Full-Blue-Racing/BSPD-27/BSPD-27_BOM.csv

Designators | Value | MPN | Distributor | Distributor code | Availability | Reference BOM (original) | Exact match? | Final confirm | Footprint | Footprint in KiCad lib? | Qty | Line price | Unit price
C1, C3, C6 | 100uF 25V | RVT1E101M0607 | LCSC | C72477 | In stock | 865080445010.0001 | No (equiv alu-elec) | Y | Capacitor_SMD:CP_Elec_6.3x7.7 | Yes | 3.0 | 0.1047 | 0.0349
C2, C4, C7, C8, C9, C10, C12, C14 | 0.1uF | CC0805KRX7R9BB104 | LCSC | C49678 | In stock | MT31B104K101CT | No (0805 X7R commercial) | Y | Capacitor_SMD:C_0805_2012Metric | Yes | 8.0 | 0.12000000000000001 | 0.015000000000000001
C5, C11, C13 | 10uF | CL21A106KAYNNNE | LCSC | C15850 | In stock | C1206C106J3RACAUTO | No (0805) | Y | Capacitor_SMD:C_0805_2012Metric | Yes | 3.0 | 0.23190000000000002 | 0.07730000000000001
COMP1, COMP2, COMP3 | MCP6547 (RRIO OD comp) | MCP6547T-E/MS | Farnell | 2851683.0 | In stock (65) | not in original BOM | n/a (AEC-Q100) | Y | Package_SO:MSOP-8_3x3mm_P0.65mm | Yes | 3.0 | 1.4100000000000001 | 0.47000000000000003
D1 | P6KE18A (18V TVS) | P6SMB18A | LCSC | C80394 | In stock (1,570) | P6KE18A | Yes - SMD sub for P6KE18A (uni-dir 600W) | OPEN | Diode_SMD:D_SMB | Yes | 1.0 | 0.152 | 0.152
D2 | 1N5822 (40V 3A) | 1N5822 | LCSC | C52023798 | In stock (44,570) | 1N5822 | Yes | Y | Diode_THT:D_DO-201AD_P12.70mm_Horizontal (verify pitch) | Yes | 1.0 | 0.059 | 0.059
D3, D4, D5, D6, D7, D8 | SMF5.0A | SZSMF5.0AT1G | LCSC | C5299833 | In stock (12,090) | SZSMF5.0AT1G | Yes (AEC-Q101) | Y | Diode_SMD:D_SOD-123F | Yes | 6.0 | 1.0176 | 0.1696
D9 | Green LED | KP-3216MGC | LCSC | C598294 | In stock (2,965) | AP3216MGC | Approx (LCSC rename of AP3216MGC) | Y | LED_SMD:LED_1206_3216Metric | Yes | 1.0 | 0.37300000000000005 | 0.37300000000000005
D10, D11 | Red LED | KP-3216SURC | LCSC | C598298 | In stock | 599-0P10-137F | No (Kingbright 1206; BOM Dialight n/a) | Y | LED_SMD:LED_1206_3216Metric | Yes | 2.0 | 0.060000000000000005 | 0.030000000000000002
F1 | PTC 1.1A | 1812L110/33GR | LCSC | C7542972 | In stock | not in original BOM | n/a | Y | Fuse:Fuse_1812_4532Metric | Yes | 1.0 | 0.0675 | 0.0675
FB1 | 1000ohm bead | CBW321609U102T | LCSC | C113327 | In stock | 782763102.0 | No (equiv 1206 1000ohm) | Y | Inductor_SMD:L_1206_3216Metric | Yes | 1.0 | 0.0412 | 0.0412
J1 | Connector 14-way | 776267-1 | Farnell | 2798126.0 | In stock (178) + your stock | 2301843-1 (D-sub 9) | N/a (AMPSEAL 14-way; your chosen replacement) | Y | TE AMPSEAL 776267 14-pos (get from UltraLibrarian/SnapEDA) | NO | 1.0 | 9.33 | 9.33
PS1 | DC-DC 5V 1A | R-78E5.0-1.0 | Farnell | 2760747.0 | In stock (6,255) | not in original BOM | n/a | Y | Converter_DCDC:Converter_DCDC_RECOM_R-78E-0.5_THT | Yes | 1.0 | 3.4200000000000004 | 3.4200000000000004
Q1, Q2, Q3, Q5 | N-MOSFET 30V | MMFTN3404A-AQ | Farnell | 4680838.0 | In stock (1,983) | MMFTN3402 | No (AEC-Q101 upgrade; BOM was non-AEC) | Y | Package_TO_SOT_SMD:SOT-23 | Yes | 4.0 | 1.62 | 0.405
Q4 | P-MOSFET 30V | MMFTP3401-AQ | Farnell | 4855254.0 | Lead time (order min 5) | MMFTP3401-AQ | Yes (AEC-Q101) | Y | Package_TO_SOT_SMD:SOT-23 | Yes | 1.0 | 0.3 | 0.3
R1, R6, R15, R20, R21 | 47k | 0805W8F4702T5E | LCSC | C17713 | In stock | CRGCQ1206J47K | No (0805 5% commercial) | Y | Resistor_SMD:R_0805_2012Metric | Yes | 5.0 | 0.011000000000000001 | 0.0022
R2, R3, R5, R7, R8, R10, R14, R18, R19 | 10k | 0805W8F1002T5E | LCSC | C17414 | In stock | CRCW120610K0JNEA | No (0805 5% commercial) | Y | Resistor_SMD:R_0805_2012Metric | Yes | 9.0 | 0.0148 | 0.0016
R4, R9, R11, R12, R13, R17, R25, R26 | 100k | ERA-8AEB104V | LCSC | C2073484 | In stock (5,615) | CRT1206-DY-1003ELF | No (0.1% AEC-Q200; BOM was 0.5%) | Y | Resistor_SMD:R_1206_3216Metric | Yes | 8.0 | 2.8544 | 0.3568
R16 | 1M | RT1206DRE071ML | LCSC | C872103 | In stock (1,540) | RT1206DRE071ML | Yes | Y | Resistor_SMD:R_1206_3216Metric | Yes | 1.0 | 0.0245 | 0.0245
R22, R23, R24 | 2.2k | ERA-8AEB222V | LCSC | C2075444 | In stock (3,180) | ERJ-P08D2201V | No (0.1% AEC-Q200; BOM was 0.5%) | Y | Resistor_SMD:R_1206_3216Metric | Yes | 3.0 | 0.43350000000000005 | 0.14450000000000002
RELAY1 | Relay SPDT 12V 15A | MCCMA51-S-DC12V-C | Farnell | 2008759.0 | In stock (4,809) | not in original BOM | n/a (automotive; 15A vs G5V-1 2A) | Y | TE CMA51 series (get from UltraLibrarian/SnapEDA) | NO | 1.0 | 2.15 | 2.15
VR1, VR2, VR3, VR4 | 100k trim (multiturn) | 3296W-1-104LF | LCSC | C48084 | In stock (13,933) | 3296W-1-104LF | Yes | Y | Potentiometer_THT:Potentiometer_Bourns_3296W_Vertical | Yes | 4.0 | 3.2648 | 0.8162
VR5, VR6 | 100k trim (SMD) | 3314G-1-104E | LCSC | C780219 | In stock (2,452) | 06TR4BA104DPR | No (CTS n/a on LCSC; Bourns 3314G SMD single-turn - same form/turns) | Y | Potentiometer_SMD:Potentiometer_Bourns_3314G_Vertical | Yes | 2.0 | 1.1342 | 0.5671
IC1 | Quad AND gate | SN74HC08QDRQ1 | LCSC | C2866596 | In stock (210) | MC74HC08ADR2G-Q | No (TI AEC-Q100 equiv; diff mfr) |  | Package_SO:SOIC-14_3.9x8.7mm_P1.27mm | Yes | 1.0 | 0.46220000000000006 | 0.46220000000000006
