Full-Blue-Racing/BSPD-27/production/BSPD27_bom.csv

Designator | Footprint | Quantity | Value | LCSC Part #
C1, C3, C6 | CP_Elec_6.3x7.7 | 3 | 100u 25V | C72477
C10, C12, C14, C15, C16, C2, C4, C7, C8, C9 | 0805 | 10 | 0.1u | C49678
C11, C13, C5 | 0805 | 3 | 10u | C15850
COMP1, COMP2, COMP3 | MSOP-8_3x3mm_P0.65mm | 3 | MCP6547-I_P | MCP6547T-E/MS
D1 | D_SMB | 1 | P6SMB18A | C80394
D10 | 1206 | 1 | Red | C598298
D11 | 1206 | 1 | PWR | C598298
D12 | D_DO-41_SOD81_P10.16mm_Horizontal | 1 | 1N5817 | C315569
D13 | 1206 | 1 | Thr_EN | C598298
D14 | 1206 | 1 | Thr_Plugged | C598294
D15 | 1206 | 1 | Brk_EN | C598298
D16 | 1206 | 1 | Brk_Plugged | C598294
D17 | 1206 | 1 | SEN_Implaus | C598298
D18 | 1206 | 1 | SEN_Unplugged | C598298
D19 | 1206 | 1 | R_on | C598298
D2 | D_DO-201AD_P12.70mm_Horizontal | 1 | 1N5822 | C52023798
D9 | 1206 | 1 | GRN | C598294
F1 | 1812 | 1 | 30R110 | C7542972
FB1 | 1206 | 1 | FerriteBead | C113327
IC1 | SOIC-14_3.9x8.7mm_P1.27mm | 1 | MC74HC08ADR2G-Q | C7578
J1 | TE_776267-1 | 1 | Conn_01x14
K1 | MCCMA51-S-DC12V-C | 1 | MCCMA51-S-DC12V-C
PS1 | Converter_DCDC_RECOM_R-78E-0.5_THT | 1 | R-78E5.0-1.0 | R-78E5.0-1.0
Q1, Q2, Q3, Q5 | SOT-23 | 4 | MMFTN3404A-AQ | MMFTN3404A-AQ
Q4 | SOT-23 | 1 | MMFTP3401-AQ | MMFTP3401-AQ
R1, R15, R20, R21, R7 | 0805 | 5 | 47k | C17713
R10, R22, R23, R24, R28, R29, R33, R34, R35, R4 | 1206 | 10 | 1k | C4410
R11, R12, R13, R17, R25, R27, R6 | 1206 | 7 | 100k | C2073484
R14, R18, R19, R2, R26, R3, R36, R37, R38, R5, R8, R9 | 0805 | 12 | 10k | C17414
R16 | 1206 | 1 | 1M | C872103
R30, R32 | 1206 | 2 | 5.1k | C2933721
R31 | 1206 | 1 | 91k | C2933797
TP1 | TestPoint_Loop_D2.54mm_Drill1.5mm_Beaded | 1 | BRK_IN
TP10 | TestPoint_Pad_D2.0mm | 1 | Thr_Thresh-
TP11 | TestPoint_Loop_D2.54mm_Drill1.5mm_Beaded | 1 | Brk_Thresh+
TP2 | TestPoint_Loop_D2.54mm_Drill1.5mm_Beaded | 1 | THR_IN
TP3 | TestPoint_Loop_D2.54mm_Drill1.5mm_Beaded | 1 | RC_T05
TP4 | TestPoint_Loop_D2.54mm_Drill1.5mm_Beaded | 1 | RC_T10
TP5 | TestPoint_Loop_D2.54mm_Drill1.5mm_Beaded | 1 | Thr_Thresh+
TP6 | TestPoint_Loop_D2.54mm_Drill1.5mm_Beaded | 1 | GND
TP7 | TestPoint_Pad_D2.0mm | 1 | Brk_Thresh-
TP8 | TestPoint_Loop_D2.54mm_Drill1.5mm_Beaded | 1 | +12V
TP9 | TestPoint_Pad_D2.0mm | 1 | R_on
U1 | SOIC-14_3.9x8.7mm_P1.27mm | 1 | 74HC00 | C10090
U3 | SOIC-16_3.9x9.9mm_P1.27mm | 1 | ULN2003A | C7512
U4 | SOIC-14_3.9x8.7mm_P1.27mm | 1 | LM2901 | C7932
U5 | SOIC-14_3.9x8.7mm_P1.27mm | 1 | 74HC02 | C350559
VR1 | Potentiometer_Bourns_3296W_Vertical | 1 | Brk_Thresh+ | C48084
VR2 | Potentiometer_Bourns_3296W_Vertical | 1 | Thr_Thresh+ | C48084
VR3, VR4 | Potentiometer_Bourns_3296W_Vertical | 2 | 3296W-1-xxxLF | C48084
VR5, VR6 | Potentiometer_Bourns_3314G_Vertical | 2 | 3314G | C780219
VR7 | Potentiometer_Bourns_3296W_Vertical | 1 | Brk_Thresh- | C48084
VR8 | Potentiometer_Bourns_3296W_Vertical | 1 | Thr_Thresh- | C48084
