Full-Blue-Racing/BSPD-27/production/BSPD27_bom_farnell.csv

Designator | Footprint | Quantity | Value | Farnell Part #
C1, C3, C6 | CP_Elec_6.3x7.7 | 3 | 100u 25V | 9265708
C10, C12, C14, C15, C16, C2, C4, C7, C8, C9 | 0805 | 10 | 0.1u | 2496944
C11, C13, C5 | 0805 | 3 | 10u | 2320833
COMP1, COMP2, COMP3 | MSOP-8_3x3mm_P0.65mm | 3 | MCP6547-I_P | 2851683
D1 | D_SMB | 1 | P6SMB18A | 1886331
D10 | 1206 | 1 | Red | 8530114
D11 | 1206 | 1 | PWR | 8530114
D12 | D_DO-41_SOD81_P10.16mm_Horizontal | 1 | 1N5817 | 9843787
D13 | 1206 | 1 | Thr_EN | 8530114
D14 | 1206 | 1 | Thr_Plugged | 2099244
D15 | 1206 | 1 | Brk_EN | 8530114
D16 | 1206 | 1 | Brk_Plugged | 2099244
D17 | 1206 | 1 | SEN_Implaus | 8530114
D18 | 1206 | 1 | SEN_Unplugged | 8530114
D19 | 1206 | 1 | R_on | 8530114
D2 | D_DO-201AD_P12.70mm_Horizontal | 1 | 1N5822 | 2322473
D9 | 1206 | 1 | GRN | 2099244
F1 | 1812 | 1 | 30R110 | 2383302
FB1 | 1206 | 1 | FerriteBead | 2292418
IC1 | SOIC-14_3.9x8.7mm_P1.27mm | 1 | MC74HC08ADR2G-Q | 1201314
K1 | MCCMA51-S-DC12V-C | 1 | MCCMA51-S-DC12V-C | 2008759
PS1 | Converter_DCDC_RECOM_R-78E-0.5_THT | 1 | R-78E5.0-1.0 | 2760747
Q1, Q2, Q3, Q5 | SOT-23 | 4 | MMFTN3404A-AQ | 4680838
Q4 | SOT-23 | 1 | MMFTP3401 | 4710426
R1, R15, R20, R21, R7 | 0805 | 5 | 47k | 2502732
R10, R22, R23, R24, R28, R29, R33, R34, R35, R4 | 1206 | 10 | 1k | 2447473
R11, R12, R13, R17, R25, R27, R6 | 1206 | 7 | 100k | 2447453
R14, R18, R19, R2, R26, R3, R36, R37, R38, R5, R8, R9 | 0805 | 12 | 10k | 2447553
R16 | 1206 | 1 | 1M | 2447478
R30, R32 | 1206 | 2 | 5.1k | 2695164
R31 | 1206 | 1 | 91k | 2074711
TP1, TP2, TP3, TP4, TP5, TP6, TP8, TP11 | TestPoint_Loop_D2.54mm_Drill1.5mm_Beaded | 8 | PCB Test Point (Vero 20-313141) | 2668702
U1 | SOIC-14_3.9x8.7mm_P1.27mm | 1 | 74HC00 | 1201310
U3 | SOIC-16_3.9x9.9mm_P1.27mm | 1 | ULN2003ADR | 3009692
U4 | SOIC-14_3.9x8.7mm_P1.27mm | 1 | LM2901DT | 2382614
U5 | SOIC-14_3.9x8.7mm_P1.27mm | 1 | 74HC02 | 1201312
VR1 | Potentiometer_Bourns_3296W_Vertical | 1 | Brk_Thresh+ | 9353186
VR2 | Potentiometer_Bourns_3296W_Vertical | 1 | Thr_Thresh+ | 9353186
VR3, VR4 | Potentiometer_Bourns_3296W_Vertical | 2 | 3296W-1-xxxLF | 9353186
VR5, VR6 | Potentiometer_Bourns_3314G_Vertical | 2 | 3314G | 1360937
VR7 | Potentiometer_Bourns_3296W_Vertical | 1 | Brk_Thresh- | 9353186
VR8 | Potentiometer_Bourns_3296W_Vertical | 1 | Thr_Thresh- | 9353186
