Full-Blue-Racing/BSPD-27/BSPD-E.pdf

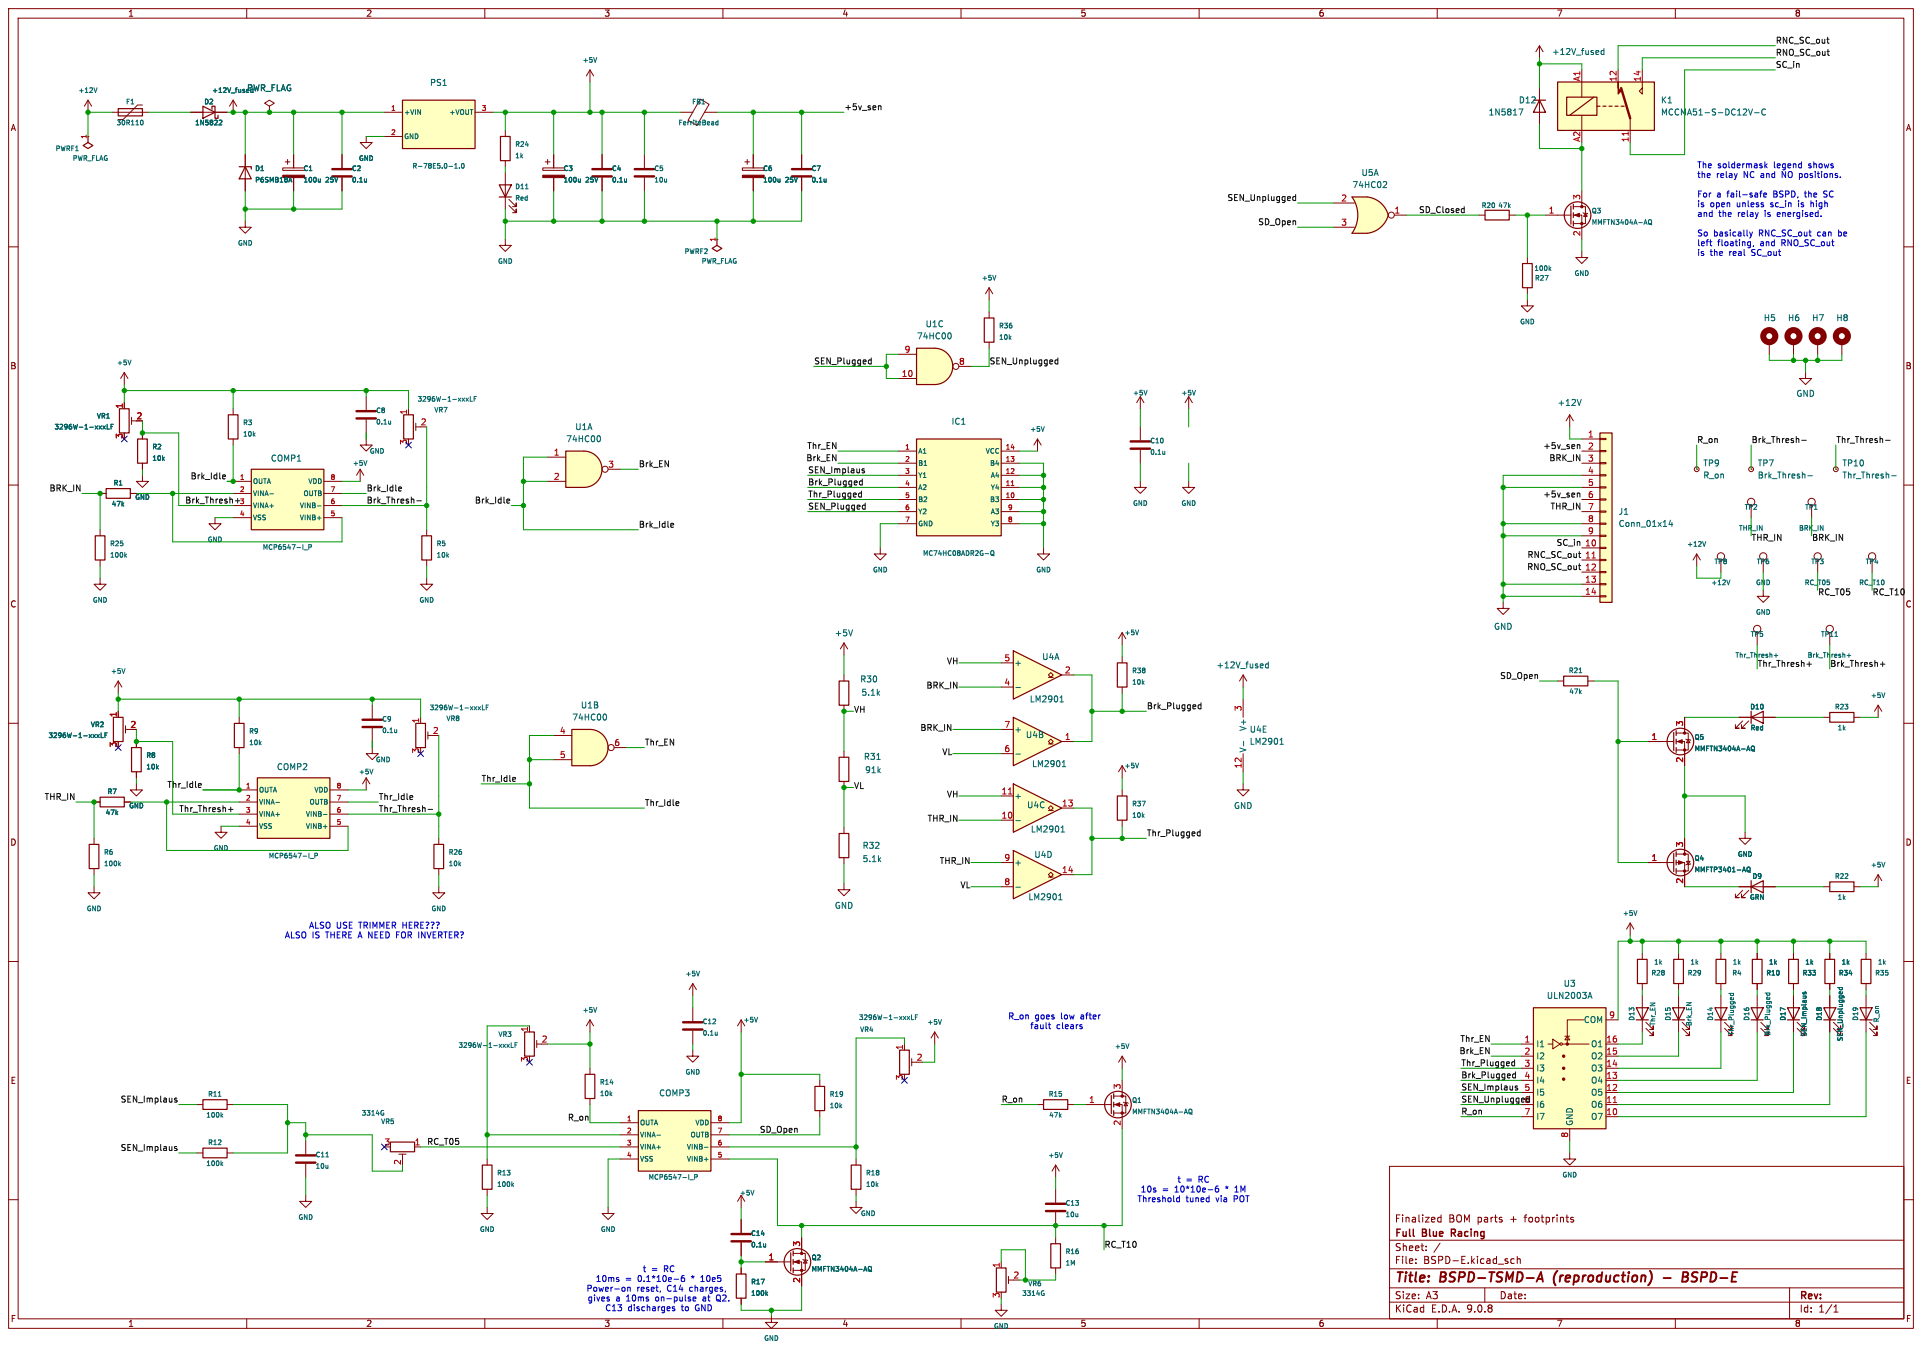
[picture p1: page 1]

is open unless sc_in is high

Threshold tuned via POT Q2 MMFTN3404A-AQ
