Full-Blue-Racing/BSPD-27/BSPD-27.kicad_pcb

## KiCad design BSPD-27.kicad_pcb (2026-10-11)

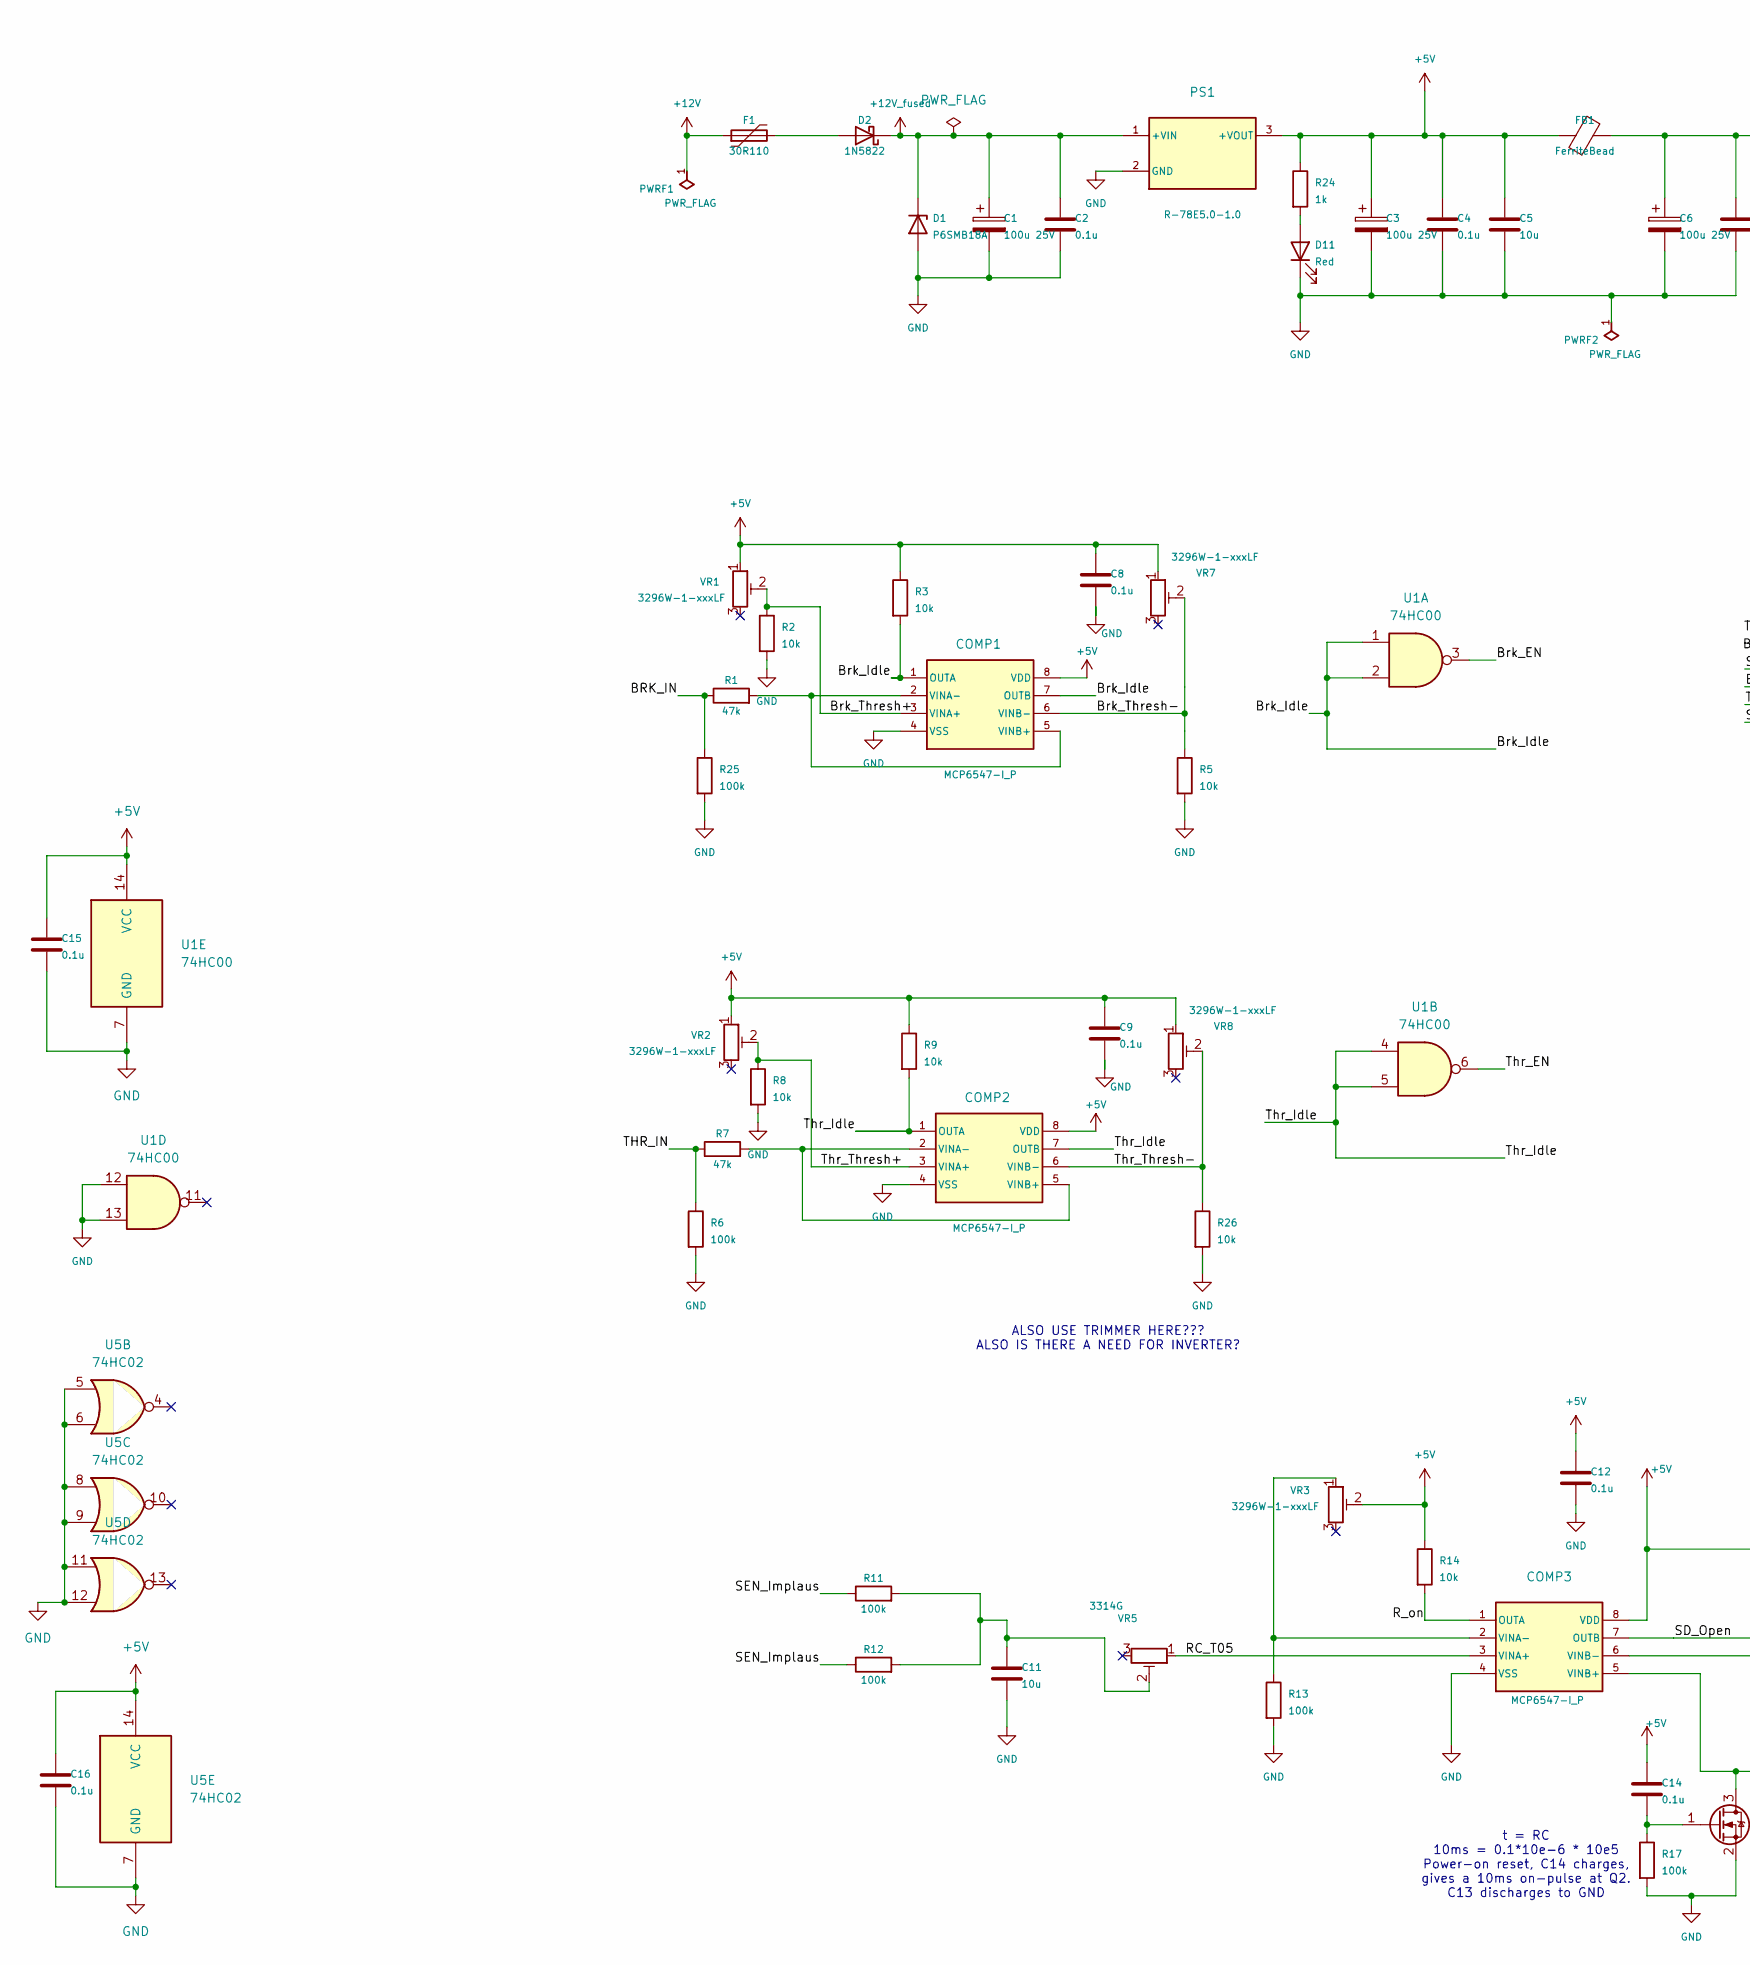
[picture p2: schematic BSPD-27.kicad_sch, BSPD-TSMD-A (reproduction) - BSPD-E, part in row 1, column 1]

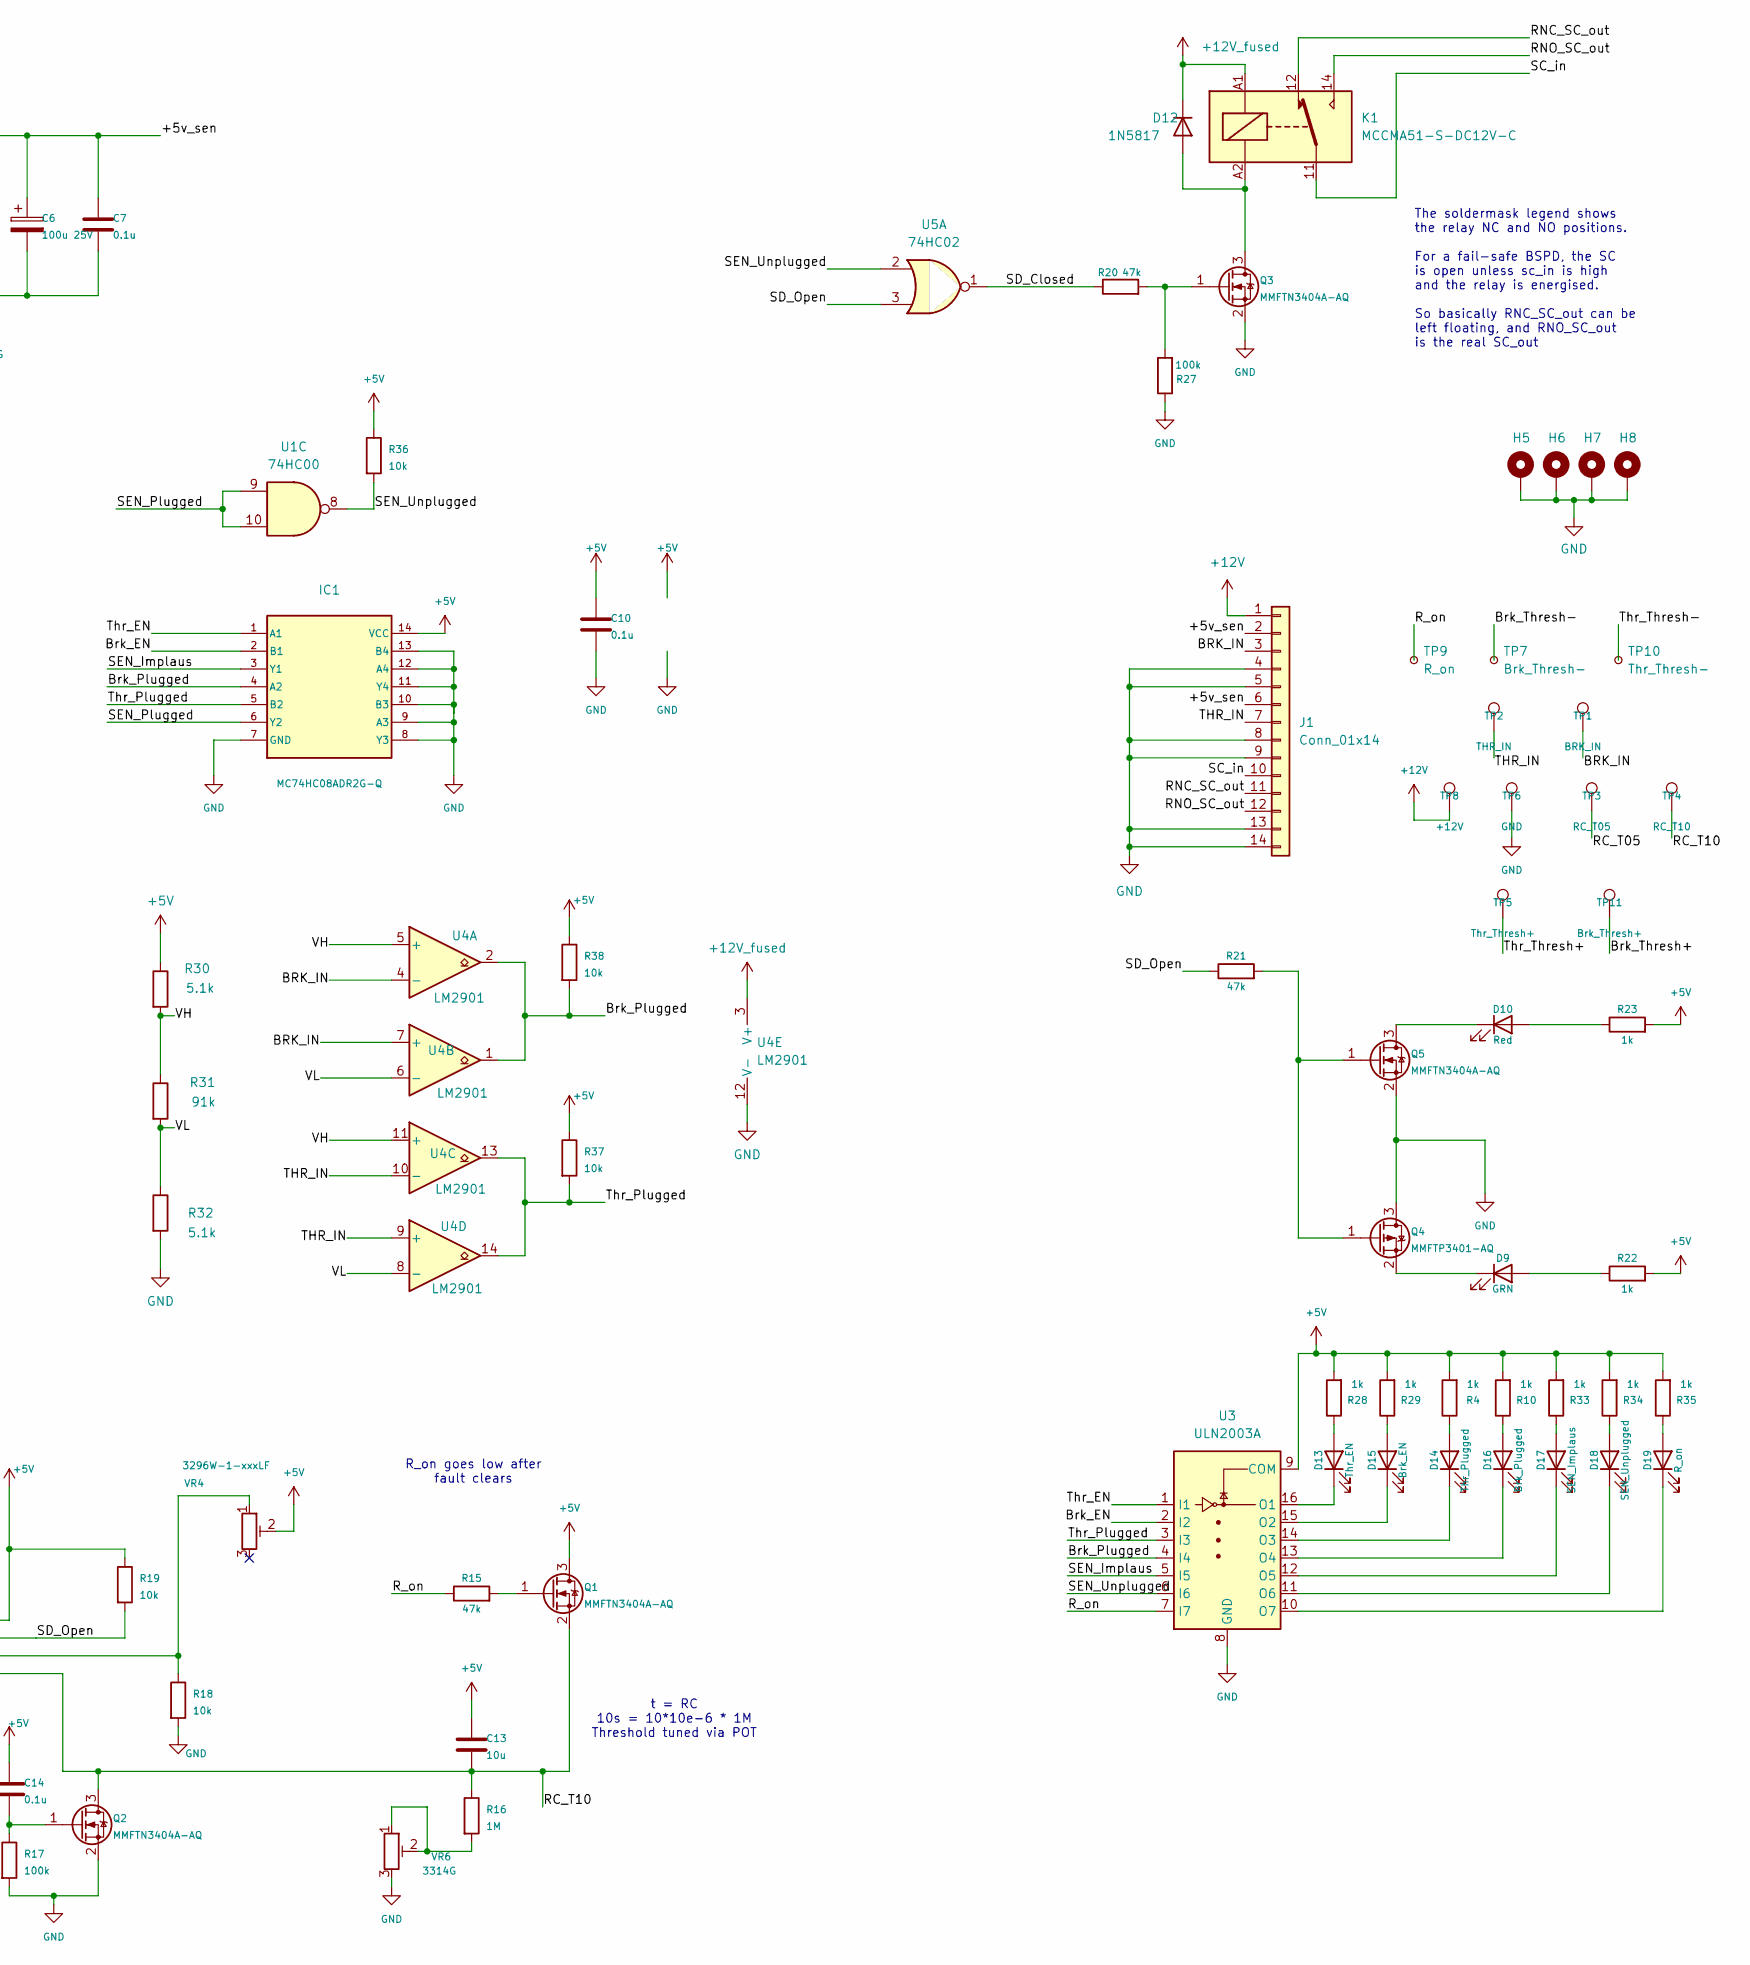
[picture p3: schematic BSPD-27.kicad_sch, BSPD-TSMD-A (reproduction) - BSPD-E, part in row 1, column 2]

Parts:
C1, C3, C6: 100u 25V; CP_Elec_6.3x7.7; MPN RVT1E101M0607; LCSC C72477
C2, C4, C7, C8, C9, C10, C12, C14, C15, C16: 0.1u; C_0805_2012Metric; MPN CC0805KRX7R9BB104; LCSC C49678
C5, C11, C13: 10u; C_0805_2012Metric; MPN CL21A106KAYNNNE; LCSC C15850
COMP1, COMP2, COMP3: MCP6547-I_P; MSOP-8_3x3mm_P0.65mm; MPN MCP6547T-E/MS; Farnell 2851683
D1: P6SMB18A; D_SMB; MPN P6SMB18A; LCSC C80394
D2: 1N5822; D_DO-201AD_P12.70mm_Horizontal; MPN 1N5822; LCSC C52023798
D9: GRN; LED_1206_3216Metric; MPN KP-3216MGC; LCSC C598294
D10, D11: Red; LED_1206_3216Metric; MPN KP-3216SURC; LCSC C598298
D12: 1N5817; D_DO-41_SOD81_P10.16mm_Horizontal; MPN 1N5817; LCSC C315569
D13: Thr_EN; LED_1206_3216Metric; MPN KP-3216SURC; LCSC C598298
D14: Thr_Plugged; LED_1206_3216Metric; MPN KP-3216MGC; LCSC C598294
D15: Brk_EN; LED_1206_3216Metric; MPN KP-3216SURC; LCSC C598298
D16: Brk_Plugged; LED_1206_3216Metric; MPN KP-3216MGC; LCSC C598294
D17: SEN_Implaus; LED_1206_3216Metric; MPN KP-3216SURC; LCSC C598298
D18: SEN_Unplugged; LED_1206_3216Metric; MPN KP-3216SURC; LCSC C598298
D19: R_on; LED_1206_3216Metric; MPN KP-3216SURC; LCSC C598298
F1: 30R110; Fuse_1812_4532Metric; MPN 1812L110/33GR; LCSC C7542972
FB1: FerriteBead; L_1206_3216Metric; MPN CBW321609U102T; LCSC C113327
H5, H6, H7, H8: MountingHole_Pad; MountingHole_3.2mm_M3_Pad_Via
IC1: MC74HC08ADR2G-Q; SOIC-14_3.9x8.7mm_P1.27mm; MPN MC74HC08ADR2G; LCSC C7578
J1: Conn_01x14; TE_776267-1
K1: MCCMA51-S-DC12V-C
PS1: R-78E5.0-1.0; Converter_DCDC_RECOM_R-78E-0.5_THT; MPN R-78E5.0-1.0; Farnell 2760747
PWRF1, PWRF2: PWR_FLAG
Q1, Q2, Q3, Q5: MMFTN3404A-AQ; SOT-23; MPN MMFTN3404A-AQ; Farnell 4680838
Q4: MMFTP3401-AQ; SOT-23; MPN MMFTP3401-AQ; Farnell 4855254
R1, R7, R15, R20, R21: 47k; R_0805_2012Metric; MPN 0805W8F4702T5E; LCSC C17713
R2, R3, R5, R8, R9, R14, R18, R19, R26, R36, R37, R38: 10k; R_0805_2012Metric; MPN 0805W8F1002T5E; LCSC C17414
R4, R10, R22, R23, R24, R28, R29, R33, R34, R35: 1k; R_1206_3216Metric; MPN 1206W4F1001T5E; LCSC C4410
R6, R11, R12, R13, R17, R25, R27: 100k; R_1206_3216Metric; MPN ERA-8AEB104V; LCSC C2073484
R16: 1M; R_1206_3216Metric; MPN RT1206DRE071ML; LCSC C872103
R30, R32: 5.1k; R_1206_3216Metric; MPN FRC1206F5101TS; LCSC C2933721
R31: 91k; R_1206_3216Metric; MPN FRC1206J913TS; LCSC C2933797
TP1: BRK_IN; TestPoint_Loop_D2.54mm_Drill1.5mm_Beaded
TP2: THR_IN; TestPoint_Loop_D2.54mm_Drill1.5mm_Beaded
TP3: RC_T05; TestPoint_Loop_D2.54mm_Drill1.5mm_Beaded
TP4: RC_T10; TestPoint_Loop_D2.54mm_Drill1.5mm_Beaded
TP5: Thr_Thresh+; TestPoint_Loop_D2.54mm_Drill1.5mm_Beaded
TP6: GND; TestPoint_Loop_D2.54mm_Drill1.5mm_Beaded
TP7: Brk_Thresh-; TestPoint_Pad_D2.0mm
TP8: +12V; TestPoint_Loop_D2.54mm_Drill1.5mm_Beaded
TP9: R_on; TestPoint_Pad_D2.0mm
TP10: Thr_Thresh-; TestPoint_Pad_D2.0mm
TP11: Brk_Thresh+; TestPoint_Loop_D2.54mm_Drill1.5mm_Beaded
U1: 74HC00; SOIC-14_3.9x8.7mm_P1.27mm; MPN SN74HC00DR; LCSC C10090
U3: ULN2003A; SOIC-16_3.9x9.9mm_P1.27mm; MPN ULN2003ADR; LCSC C7512
U4: LM2901; SOIC-14_3.9x8.7mm_P1.27mm; MPN LM2901DR; LCSC C7932
U5: 74HC02; SOIC-14_3.9x8.7mm_P1.27mm; MPN SN74HC02DR; LCSC C350559
VR1, VR2, VR3, VR4, VR7, VR8: 3296W-1-xxxLF; Potentiometer_Bourns_3296W_Vertical; MPN 3296W-1-104LF; LCSC C48084
VR5, VR6: 3314G; Potentiometer_Bourns_3314G_Vertical; MPN 3314G-1-104E; LCSC C780219

Connections:
+5V: C3.1, C4.1, C5.1, C8.1, C9.1, C10.1, C12.1, C13.1, C14.1, C15.1, C16.1, COMP1.8 (VDD), COMP2.8 (VDD), COMP3.8 (VDD), FB1.1, IC1.14 (VCC), PS1.3 (+VOUT), Q1.3 (D), R3.1, R4.2, R9.1, R10.2, R14.1, R19.1, R22.2, R23.2, R24.1, R28.2, R29.2, R30.1, R33.2, R34.2, R35.2, R36.1, R37.1, R38.1, U1.14 (VCC), U3.9 (COM), U5.14 (VCC), VR1.1, VR2.1, VR3.2, VR4.2, VR7.1, VR8.1
+12V: F1.1, J1.1, PWRF1.1, TP8.1
+12V_fused: C1.1, C2.1, D1.1 (K), D2.1 (K), D12.1 (K), K1.A1, PS1.1 (+VIN), U4.3 (V+)
/+5v_sen: C6.1, C7.1, FB1.2, J1.2, J1.6
/BRK_IN: J1.3, R1.1, R25.1, TP1.1, U4.4 (-), U4.7 (+)
/Brk_EN: IC1.2 (B1), U1.3, U3.2 (I2)
/Brk_Idle: COMP1.1 (OUTA), COMP1.7 (OUTB), R3.2, U1.1, U1.2
/Brk_Plugged: IC1.4 (A2), R38.2, U3.4 (I4), U4.1, U4.2
/Brk_Thresh+: COMP1.3 (VINA+), R2.1, TP11.1, VR1.2
/Brk_Thresh-: COMP1.6 (VINB-), R5.1, TP7.1, VR7.2
/RC_T05: COMP3.3 (VINA+), TP3.1, VR5.1
/RC_T10: C13.2, COMP3.5 (VINB+), Q1.2 (S), Q2.3 (D), R16.1, TP4.1
/RNC_SC_out: J1.11, K1.12
/RNO_SC_out: J1.12, K1.14
/R_on: COMP3.1 (OUTA), R14.2, R15.1, TP9.1, U3.7 (I7)
/SC_in: J1.10, K1.11
/SD_Closed: R20.1, U5.1
/SD_Open: COMP3.7 (OUTB), R19.2, R21.1, U5.3
/SEN_Implaus: IC1.3 (Y1), R11.1, R12.1, U3.5 (I5)
/SEN_Plugged: IC1.6 (Y2), U1.9, U1.10
/SEN_Unplugged: R36.2, U1.8, U3.6 (I6), U5.2
/THR_IN: J1.7, R6.1, R7.1, TP2.1, U4.9 (+), U4.10 (-)
/Thr_EN: IC1.1 (A1), U1.6, U3.1 (I1)
/Thr_Idle: COMP2.1 (OUTA), COMP2.7 (OUTB), R9.2, U1.4, U1.5
/Thr_Plugged: IC1.5 (B2), R37.2, U3.3 (I3), U4.13, U4.14
/Thr_Thresh+: COMP2.3 (VINA+), R8.1, TP5.1, VR2.2
/Thr_Thresh-: COMP2.6 (VINB-), R26.1, TP10.1, VR8.2
/VH: R30.2, R31.1, U4.5 (+), U4.11 (+)
/VL: R31.2, R32.1, U4.6 (-), U4.8 (-)
GND: C1.2, C2.2, C3.2, C4.2, C5.2, C6.2, C7.2, C8.2, C9.2, C10.2, C11.2, C12.2, C15.2, C16.2, COMP1.4 (VSS), COMP2.4 (VSS), COMP3.4 (VSS), D1.2 (A), D11.1 (K), H5.1, H6.1, H7.1, H8.1, IC1.7 (GND), IC1.8 (Y3), IC1.9 (A3), IC1.10 (B3), IC1.11 (Y4), IC1.12 (A4), IC1.13 (B4), J1.4, J1.5, J1.8, J1.9, J1.13, J1.14, PS1.2 (GND), PWRF2.1, Q2.2 (S), Q3.2 (S), Q4.3 (D), Q5.2 (S), R2.2, R5.2, R6.2, R8.2, R13.2, R17.2, R18.2, R25.2, R26.2, R27.1, R32.2, TP6.1, U1.7 (GND), U1.12, U1.13, U3.8 (GND), U4.12 (V-), U5.5, U5.6, U5.7 (GND), U5.8, U5.9, U5.11, U5.12, VR6.3
unnamed: C11.1, R11.2, R12.2, VR5.2
unnamed: COMP1.2 (VINA-), COMP1.5 (VINB+), R1.2
unnamed: COMP2.2 (VINA-), COMP2.5 (VINB+), R7.2
unnamed: COMP3.2 (VINA-), R13.1, VR3.1
unnamed: COMP3.6 (VINB-), R18.1, VR4.1
unnamed: D2.2 (A), F1.2
unnamed: D9.2 (A), R22.1
unnamed: D9.1 (K), Q4.2 (S)
unnamed: D10.2 (A), R23.1
unnamed: D10.1 (K), Q5.3 (D)
unnamed: D11.2 (A), R24.2
unnamed: D12.2 (A), K1.A2, Q3.3 (D)
unnamed: D13.2 (A), R28.1
unnamed: D13.1 (K), U3.16 (O1)
unnamed: D14.2 (A), R4.1
unnamed: D14.1 (K), U3.14 (O3)
unnamed: D15.2 (A), R29.1
unnamed: D15.1 (K), U3.15 (O2)
unnamed: D16.2 (A), R10.1
unnamed: D16.1 (K), U3.13 (O4)
unnamed: D17.2 (A), R33.1
unnamed: D17.1 (K), U3.12 (O5)
unnamed: D18.2 (A), R34.1
unnamed: D18.1 (K), U3.11 (O6)
unnamed: D19.2 (A), R35.1
unnamed: D19.1 (K), U3.10 (O7)
unnamed: Q1.1 (G), R15.2
unnamed: C14.2, Q2.1 (G), R17.1
unnamed: Q3.1 (G), R20.2, R27.2
unnamed: Q4.1 (G), Q5.1 (G), R21.2
unnamed: R16.2, VR6.1, VR6.2

Notes on the sheet:
The soldermask legend shows the relay NC and NO positions. For a fail-safe BSPD, the SC is open unless sc_in is high and the relay is energised. So basically RNC_SC_out can be left floating, and RNO_SC_out is the real SC_out
R_on goes low after fault clears
ALSO USE TRIMMER HERE??? ALSO IS THERE A NEED FOR INVERTER?
t = RC 10ms = 0.1*10e-6 * 10e5 Power-on reset, C14 charges, gives a 10ms on-pulse at Q2. C13 discharges to GND
t = RC 10s = 10*10e-6 * 1M Threshold tuned via POT

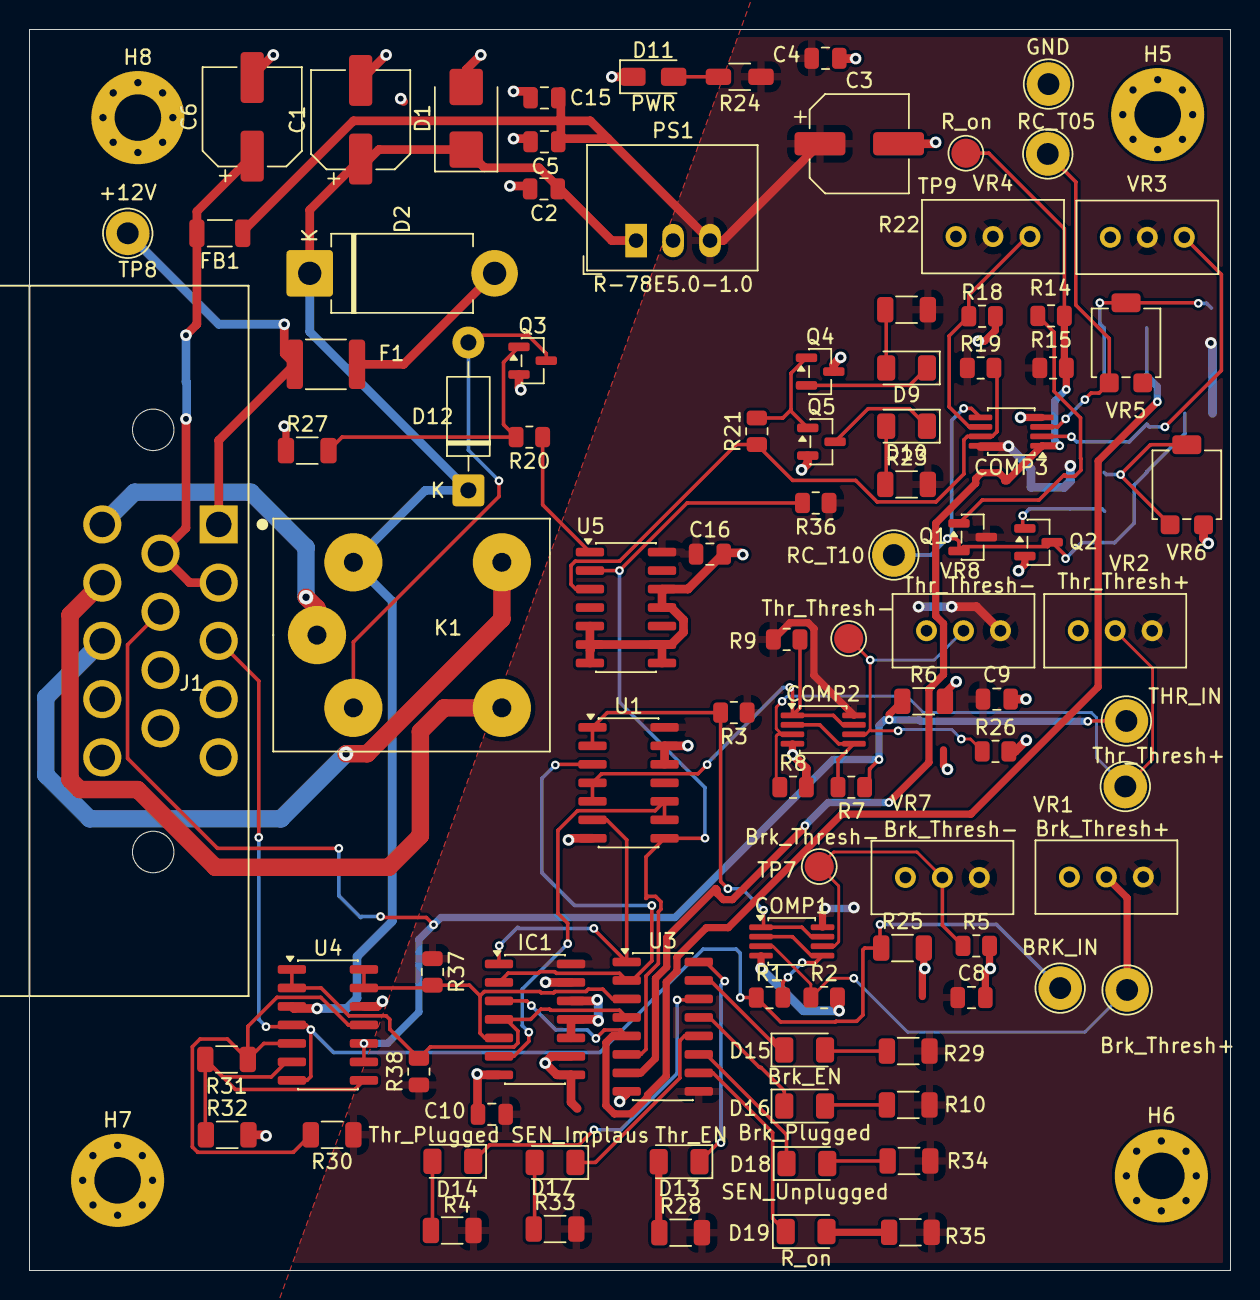
[picture p4: board BSPD-27.kicad_pcb from above]

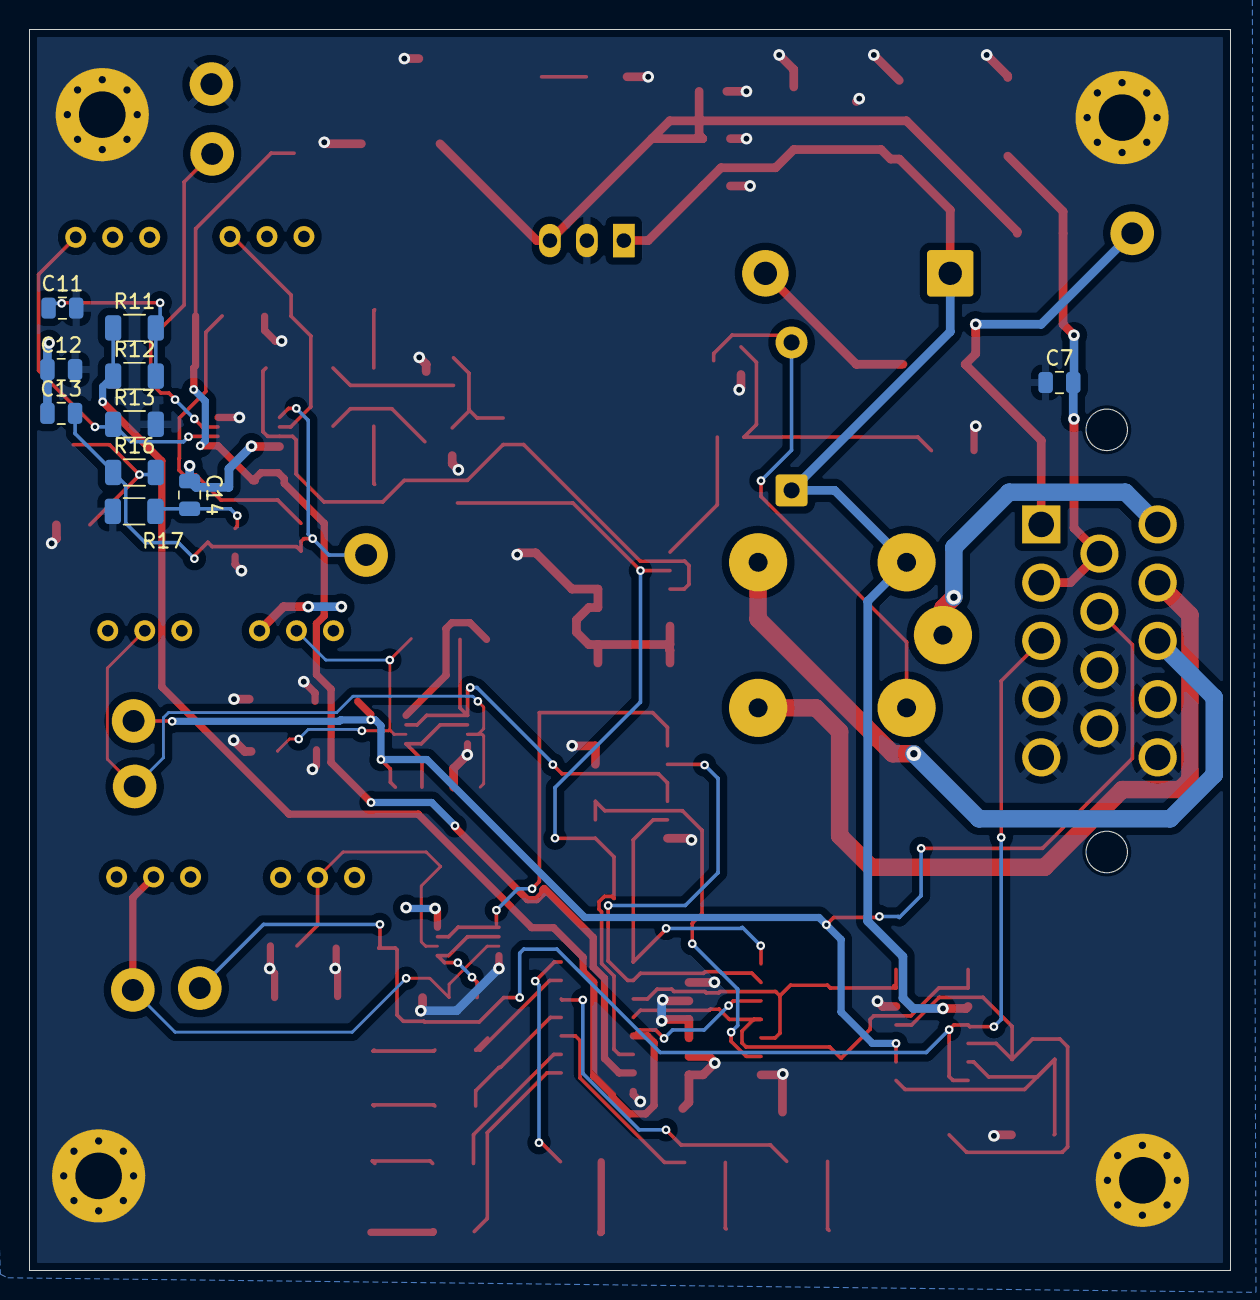
[picture p5: board BSPD-27.kicad_pcb from below]

Board: 2 copper layers, 82.5 x 85.2 mm, 108 parts (10 on the bottom side), 61 nets.
